linuxer41/velocista/arduino/plots.png

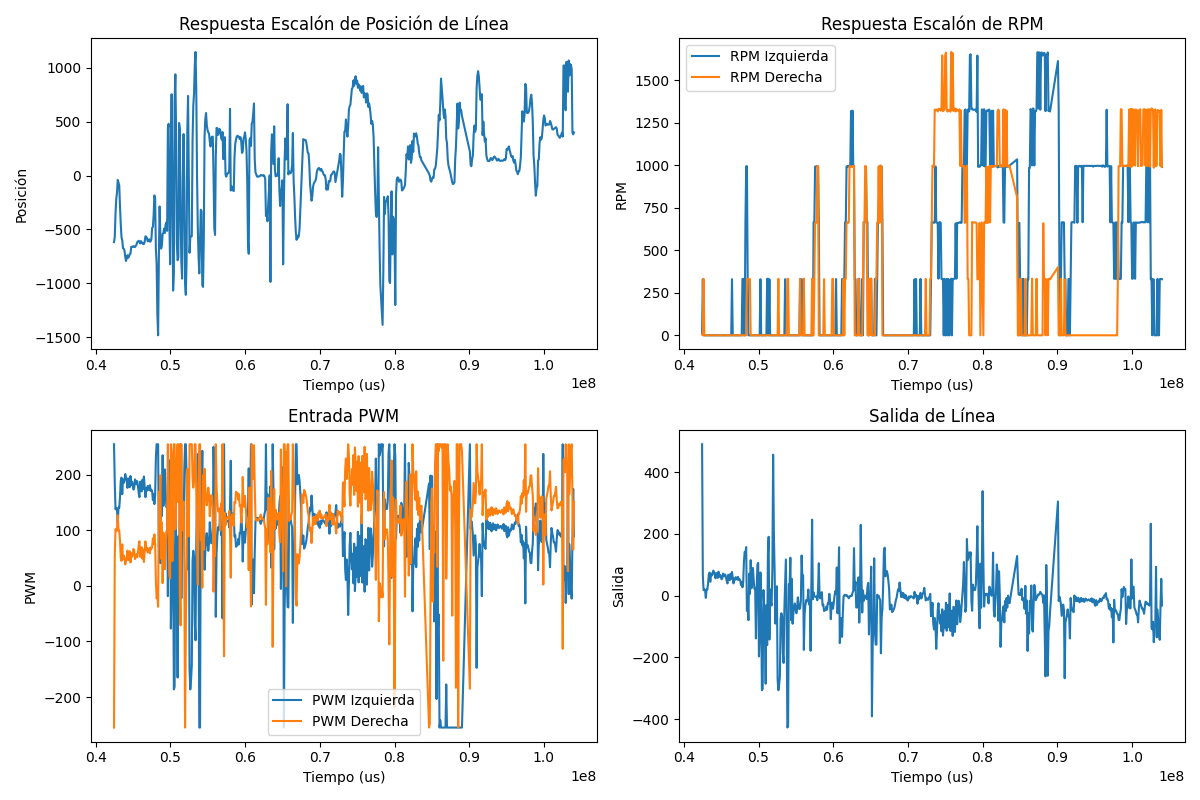
arduino/plots.png
