linuxer41/velocista/frontend/flutter_01.png

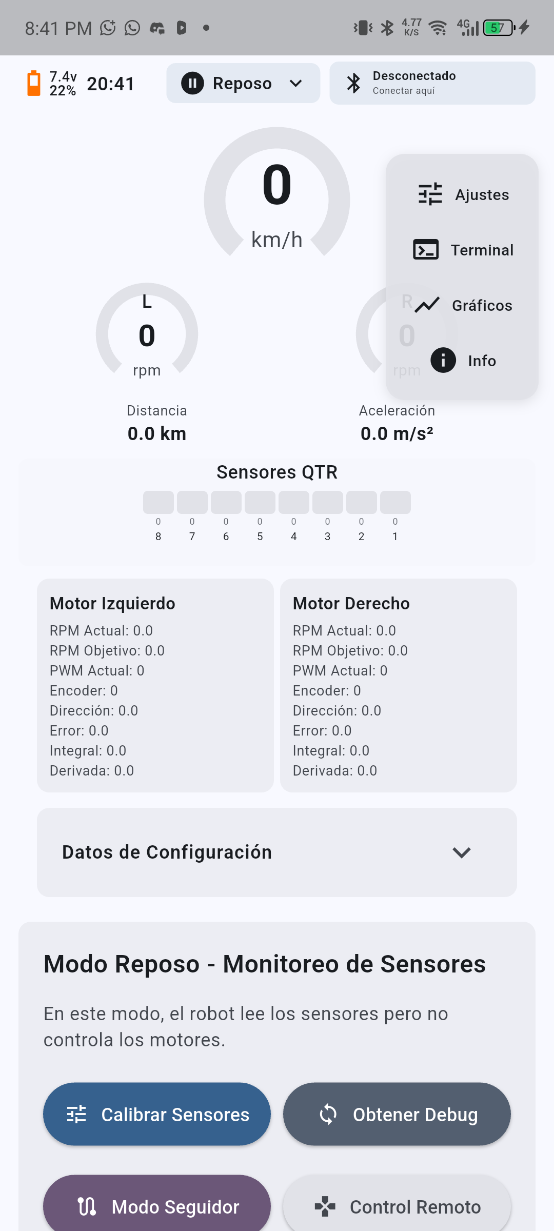
frontend/flutter_01.png
