linuxer41/velocista/(list of files, drawings)

Other design files:
Project Backups/proyecto [20251108, 08-14-47].pdsprj
Project Backups/proyecto [20251108, 08-33-21].pdsprj
proyecto.pdsprj
