linuxer41/velocista/(commit log)

2025-11-09 reformate data
    [proyecto [20251108, 08-14-47].pdsprj, proyecto [20251108, 08-33-21].pdsprj, proyecto.pdsprj]
2025-11-11 fix arduino data
2025-11-11 fix pid
2025-11-11 update change pid
2025-11-15 refactor(server): update motor control, encoder handling, and QTR calibration
    - Swap motor pins and add encoder library dependency
    - Introduce MotorSide enum and replace isLeft with side in Motor struct
    - Update encoder ISR logic and add input pullup for pins
    - Add constants for wheel PPR, reduction, and pulses per cm
    - Modify PID control to conditionally apply based on mode and useRPMControl flag
    - Change linePID output from RPM to PWM correction
    - Update Servo struct to use ticks instead of distance for positioning
    - Save and load QTR calibration from EEPROM with validation
    - Adjust default PID values for line following and add setpoint command support
    - Remove obsolete telemetry fields an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
    [main.cpp]
2025-11-19 work odometry
2025-11-30 add filters
2025-12-02 fixed velocistas
2025-12-02 luego de limpieza
2025-12-12 fixed all informe
    [data.csv]
2025-12-12 ignore files
    [data.csv]
2025-12-12 add new
    [data.csv]
2025-12-12 add new 2
    [data.csv]
